ScionResearch/machine-access-interlock-controller/hardware/Models/Case bottom.stl

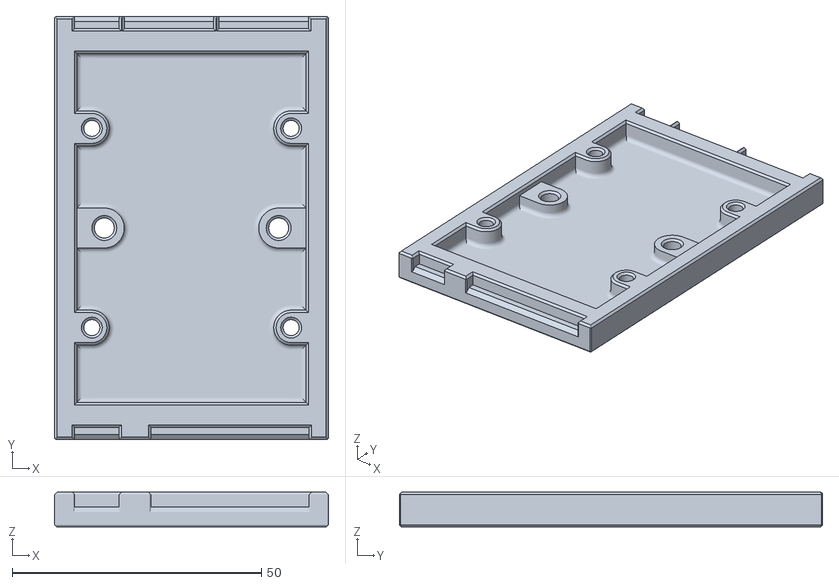
[picture p1: CAD file, 2025-06-13]
hardware/Models/Case bottom.stl
55.0 x 85.0 x 7.00
