ScionResearch/machine-access-interlock-controller/hardware/Models/LED standoff.stl

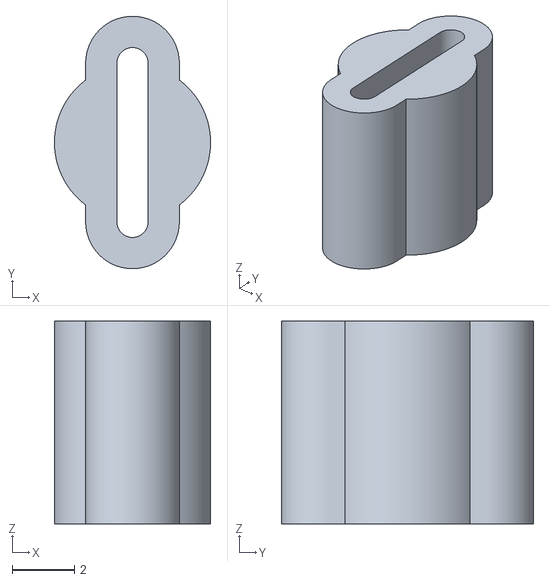
[picture p2: CAD file, 2025-06-13]
hardware/Models/LED standoff.stl
5.00 x 8.08 x 6.50
