ScionResearch/machine-access-interlock-controller/hardware/Models/Case top.stl

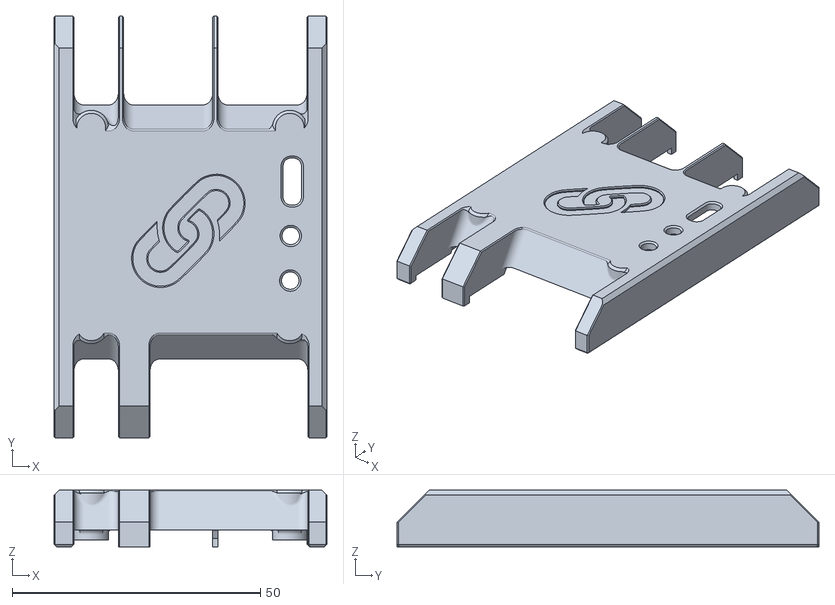
[picture p3: CAD file, 2025-06-13]
hardware/Models/Case top.stl
55.0 x 85.0 x 11.4
