ScionResearch/machine-access-interlock-controller/hardware/Machine interlock controller SCH.pdf

1

2

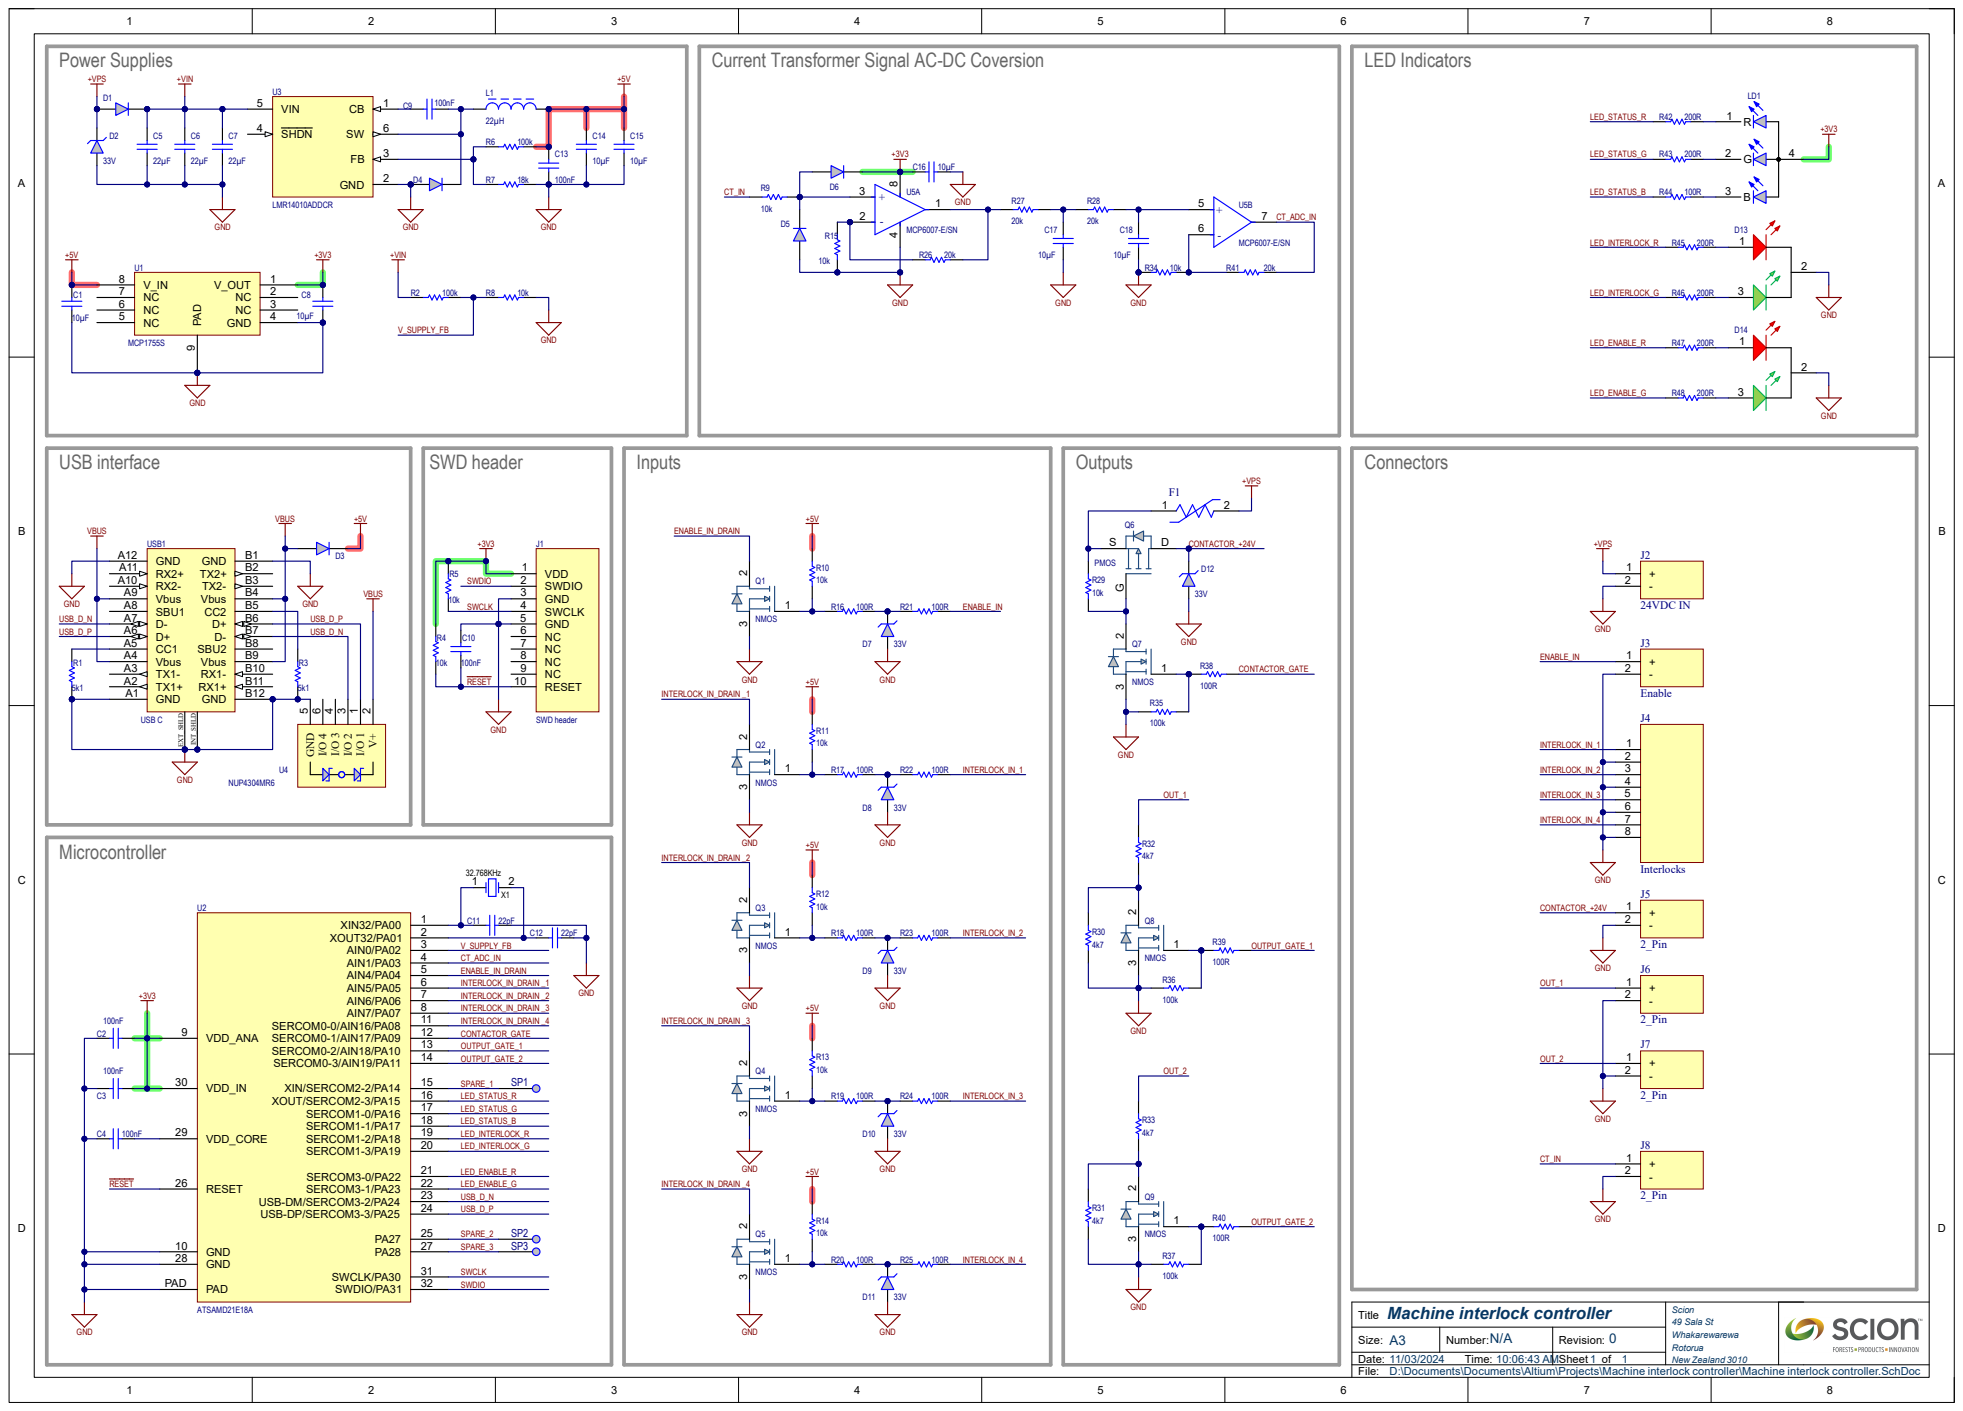
[picture p4: page 1]

Machine interlock controller
Title
D:\Documents\Documents\Altium\Projects\Machine interlock controller\Machine interlock controller.SchDoc
