ScionResearch/machine-access-interlock-controller/(list of files, drawings)

Other design files:
hardware/ECAD/Machine interlock controller.PrjPcb
hardware/ECAD/Machine interlock controller.SchDoc
