ScionResearch/machine-access-interlock-controller/packages/variants/isc_m0/variant.h

/*
  Copyright (c) 2014-2015 Arduino LLC.  All right reserved.

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
  You should have received a copy of the GNU Lesser General Public
  License along with this library; if not, write to the Free Software
  Foundation, Inc., 51 Franklin St, Fifth Floor, Boston, MA  02110-1301  USA
*/

#ifndef _VARIANT_ISC_ZERO_
#define _VARIANT_ISC_ZERO_

// The definitions here needs a SAMD core >=1.6.10
#define ARDUINO_SAMD_VARIANT_COMPLIANCE 10610

/*----------------------------------------------------------------------------
 *        Definitions
 *----------------------------------------------------------------------------*/

/** Frequency of the board main oscillator */
#define VARIANT_MAINOSC		(32768ul)

/** Master clock frequency */
#define VARIANT_MCK	(F_CPU)

/*----------------------------------------------------------------------------
 *        Headers
 *----------------------------------------------------------------------------*/

#include "WVariant.h"

#ifdef __cplusplus
#include "SERCOM.h"
#include "Uart.h"
#endif // __cplusplus

#ifdef __cplusplus
extern "C"
{
#endif // __cplusplus

/*----------------------------------------------------------------------------
 *        Pins
 *----------------------------------------------------------------------------*/

// Number of pins defined in PinDescription array
#define PINS_COUNT           (21u)
#define NUM_DIGITAL_PINS     (21u)
#define NUM_ANALOG_INPUTS    (9u)
#define NUM_ANALOG_OUTPUTS   (1u)
#define analogInputToDigitalPin(p)  (p)

#define digitalPinToPort(P)        ( &(PORT->Group[g_APinDescription[P].ulPort]) )
#define digitalPinToBitMask(P)     ( 1 << g_APinDescription[P].ulPin )
//#define analogInPinToBit(P)        ( )
#define portOutputRegister(port)   ( &(port->OUT.reg) )
#define portInputRegister(port)    ( &(port->IN.reg) )
#define portModeRegister(port)     ( &(port->DIR.reg) )
#define digitalPinHasPWM(P)        ( g_APinDescription[P].ulPWMChannel != NOT_ON_PWM || g_APinDescription[P].ulTCChannel != NOT_ON_TIMER )

/*
 * digitalPinToTimer(..) is AVR-specific and is not defined for SAMD
 * architecture. If you need to check if a pin supports PWM you must
 * use digitalPinHasPWM(..).
 *
 * https://github.com/arduino/Arduino/issues/1833
 */
 
// LEDs
#define PIN_LED              (17u)
#define LED_BUILTIN          PIN_LED
#define LED_RED          	 (15u)
#define LED_GREEN          	 (16u)
#define LED_BLUE         	 (17u)

/*
 * Analog pins
 */
#define PIN_A0               (0ul)
#define PIN_A1               (PIN_A0 + 1)
#define PIN_A2               (PIN_A0 + 2)
#define PIN_A3               (PIN_A0 + 3)
#define PIN_A6               (PIN_A0 + 6)
#define PIN_A7               (PIN_A0 + 7)
#define PIN_A8               (PIN_A0 + 8)
#define PIN_A9               (PIN_A0 + 9)
#define PIN_A10              (PIN_A0 + 10)
#define PIN_DAC0             (00ul)

static const uint8_t A0  = PIN_A0;
static const uint8_t A1  = PIN_A1;
static const uint8_t A2  = PIN_A2;
static const uint8_t A3  = PIN_A3;
static const uint8_t A6  = PIN_A6 ;
static const uint8_t A7  = PIN_A7 ;
static const uint8_t A8  = PIN_A8 ;
static const uint8_t A9  = PIN_A9 ;
static const uint8_t A10 = PIN_A10 ;
static const uint8_t DAC0 = PIN_DAC0;

#define ADC_RESOLUTION		12

/*
 * Serial interfaces
 */

// Serial1
#define PIN_SERIAL1_TX       (22ul)
#define PIN_SERIAL1_RX       (23ul)
#define PAD_SERIAL1_TX       (UART_TX_PAD_0)
#define PAD_SERIAL1_RX       (SERCOM_RX_PAD_1)

/*
 * SPI Interfaces
 */
#define SPI_INTERFACES_COUNT 1

#define PIN_SPI_SCK          (19u)
#define PIN_SPI_MISO         (22u)
#define PIN_SPI_MOSI         (18u)
#define PERIPH_SPI           sercom3
#define PAD_SPI_TX           SPI_PAD_2_SCK_3
#define PAD_SPI_RX           SERCOM_RX_PAD_0

static const uint8_t SS	  = PIN_A0 ;	// unused, just for reference
static const uint8_t MOSI = PIN_SPI_MOSI ;
static const uint8_t MISO = PIN_SPI_MISO ;
static const uint8_t SCK  = PIN_SPI_SCK ;

/*
 * Wire Interfaces
 */
#define WIRE_INTERFACES_COUNT 2

#define PIN_WIRE_SDA         (8u)
#define PIN_WIRE_SCL         (9u)
#define PERIPH_WIRE          sercom2
#define WIRE_IT_HANDLER      SERCOM2_Handler

static const uint8_t SDA = PIN_WIRE_SDA;
static const uint8_t SCL = PIN_WIRE_SCL;

#define PIN_WIRE1_SDA         (16u)
#define PIN_WIRE1_SCL         (17u)
#define PERIPH_WIRE1          sercom1
#define WIRE1_IT_HANDLER      SERCOM1_Handler

static const uint8_t SDA1 = PIN_WIRE1_SDA;
static const uint8_t SCL1 = PIN_WIRE1_SCL;

/*
 * USB
 */
#define PIN_USB_DM                      (24ul)
#define PIN_USB_DP                      (25ul)
#define PIN_USB_HOST_ENABLE				(26ul)
/*
 * I2S Interfaces
 */
#define I2S_INTERFACES_COUNT 1

#define I2S_DEVICE          0
#define I2S_CLOCK_GENERATOR 3
#define PIN_I2S_SD          (A7)
#define PIN_I2S_SCK         (MOSI)
#define PIN_I2S_FS          (SCK)

#ifdef __cplusplus
}
#endif

/*----------------------------------------------------------------------------
 *        Arduino objects - C++ only
 *----------------------------------------------------------------------------*/

#ifdef __cplusplus

/*	=========================
 *	===== SERCOM DEFINITION
 *	=========================
*/
extern SERCOM sercom0;
extern SERCOM sercom1;
extern SERCOM sercom2;
extern SERCOM sercom3;
extern SERCOM sercom4;
extern SERCOM sercom5;

extern Uart Serial1;

#endif

// These serial port names are intended to allow libraries and architecture-neutral
// sketches to automatically default to the correct port name for a particular type
// of use.  For example, a GPS module would normally connect to SERIAL_PORT_HARDWARE_OPEN,
// the first hardware serial port whose RX/TX pins are not dedicated to another use.
//
// SERIAL_PORT_MONITOR        Port which normally prints to the Arduino Serial Monitor
//
// SERIAL_PORT_USBVIRTUAL     Port which is USB virtual serial
//
// SERIAL_PORT_LINUXBRIDGE    Port which connects to a Linux system via Bridge library
//
// SERIAL_PORT_HARDWARE       Hardware serial port, physical RX & TX pins.
//
// SERIAL_PORT_HARDWARE_OPEN  Hardware serial ports which are open for use.  Their RX & TX
//                            pins are NOT connected to anything by default.
#define SERIAL_PORT_USBVIRTUAL      Serial
#define SERIAL_PORT_MONITOR         Serial
// Serial has no physical pins broken out, so it's not listed as HARDWARE port
#define SERIAL_PORT_HARDWARE        Serial1
#define SERIAL_PORT_HARDWARE_OPEN   Serial1

#endif /* _VARIANT_ISC_ZERO_ */
