ScionResearch/machine-access-interlock-controller/packages/bootloaders/isc_m0/selfdata.c

#include <stdint.h>
const uint8_t bootloader[8192] __attribute__ ((aligned (4))) = {
0xe0, 0x2d, 0x00, 0x20, 0x69, 0x02, 0x00, 0x00, 0x65, 0x02, 0x00, 0x00, 0x67, 0x02, 0x00, 0x00,
0x00, 0x00, 0x00, 0x00, 0x00, 0x00, 0x00, 0x00, 0x00, 0x00, 0x00, 0x00, 0x00, 0x00, 0x00, 0x00,
0x00, 0x00, 0x00, 0x00, 0x00, 0x00, 0x00, 0x00, 0x00, 0x00, 0x00, 0x00, 0x65, 0x02, 0x00, 0x00,
0x00, 0x00, 0x00, 0x00, 0x00, 0x00, 0x00, 0x00, 0x65, 0x02, 0x00, 0x00, 0x5d, 0x02, 0x00, 0x00,
0x65, 0x02, 0x00, 0x00, 0x65, 0x02, 0x00, 0x00, 0x65, 0x02, 0x00, 0x00, 0x65, 0x02, 0x00, 0x00,
0x65, 0x02, 0x00, 0x00, 0x65, 0x02, 0x00, 0x00, 0x65, 0x02, 0x00, 0x00, 0x65, 0x02, 0x00, 0x00,
0x65, 0x02, 0x00, 0x00, 0x65, 0x02, 0x00, 0x00, 0x65, 0x02, 0x00, 0x00, 0x65, 0x02, 0x00, 0x00,
0x65, 0x02, 0x00, 0x00, 0x00, 0x00, 0x00, 0x00, 0x00, 0x00, 0x00, 0x00, 0x65, 0x02, 0x00, 0x00,
0x65, 0x02, 0x00, 0x00, 0x65, 0x02, 0x00, 0x00, 0x65, 0x02, 0x00, 0x00, 0x65, 0x02, 0x00, 0x00,
0x65, 0x02, 0x00, 0x00, 0x00, 0x00, 0x00, 0x00, 0x00, 0x00, 0x00, 0x00, 0x65, 0x02, 0x00, 0x00,
0x65, 0x02, 0x00, 0x00, 0x65, 0x02, 0x00, 0x00, 0x65, 0x02, 0x00, 0x00, 0x65, 0x02, 0x00, 0x00,
0x00, 0x00, 0x00, 0x00, 0x07, 0x4b, 0x1a, 0x00, 0x19, 0x7d, 0xc9, 0x07, 0xfc, 0xd5, 0x20, 0x21,
0xff, 0x31, 0x19, 0x83, 0x04, 0x49, 0x40, 0x08, 0xd8, 0x61, 0x19, 0x80, 0x13, 0x7d, 0xdb, 0x07,
0xfc, 0xd5, 0x70, 0x47, 0x00, 0x40, 0x00, 0x41, 0x02, 0xa5, 0xff, 0xff, 0x10, 0xb5, 0x04, 0x00,
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
0x88, 0x42, 0x33, 0xd1, 0x00, 0x21, 0x1f, 0x4b, 0x1f, 0x4a, 0x93, 0x42, 0x33, 0xd3, 0xff, 0x22,
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

};
const uint16_t bootloader_crcs[] = {0x0e0c ,0x9ec6 ,0x77dd ,0x930d ,0xafaa ,0x36fc ,0x1d03 ,0x90af};
